tenhobi/maturitni-prace/fotodokumentace/budice-motoru/05.jpg

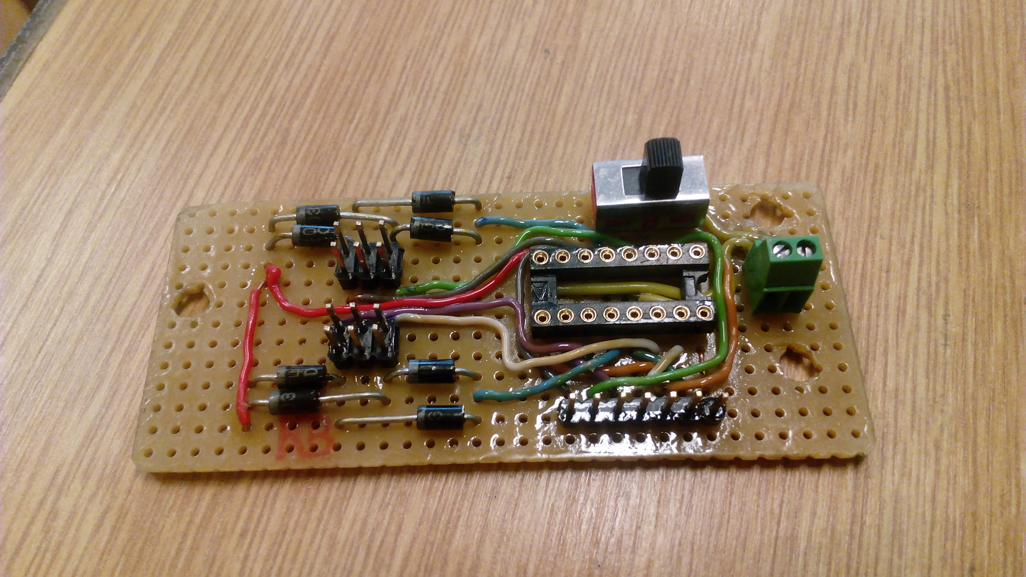
fotodokumentace/budice-motoru/05.jpg
