tenhobi/maturitni-prace/fotodokumentace/ridici-jednotka/12.jpg

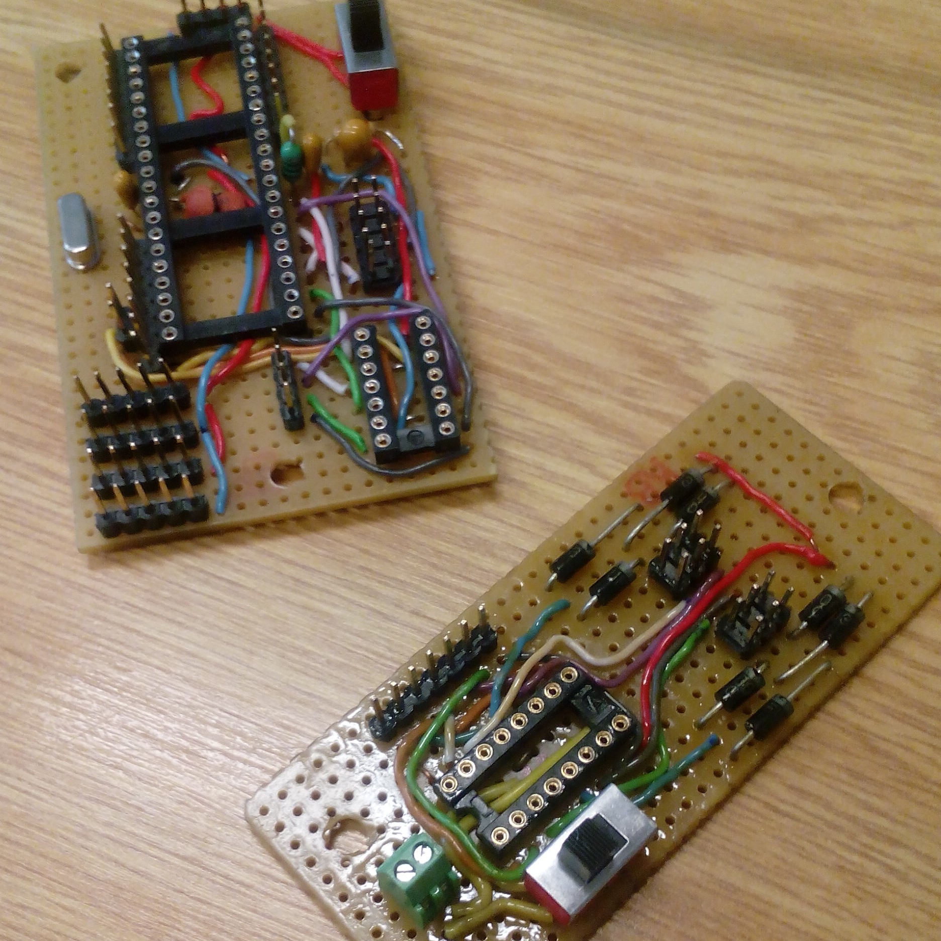
fotodokumentace/ridici-jednotka/12.jpg
