tenhobi/maturitni-prace/README.md

# Maturitní práce

Maturitní práce zabývající se programováním mikrořadiče ATmega32 v jazyku symbolických adres (tj. "assembler") pro dálkové ovládání vozítka postaveného ze stavebnice Merkur s vlastními navrženými deskami plošných spojů pro elektroniku vozítka.
