tenhobi/maturitni-prace/fotodokumentace/budice-motoru/01.jpg

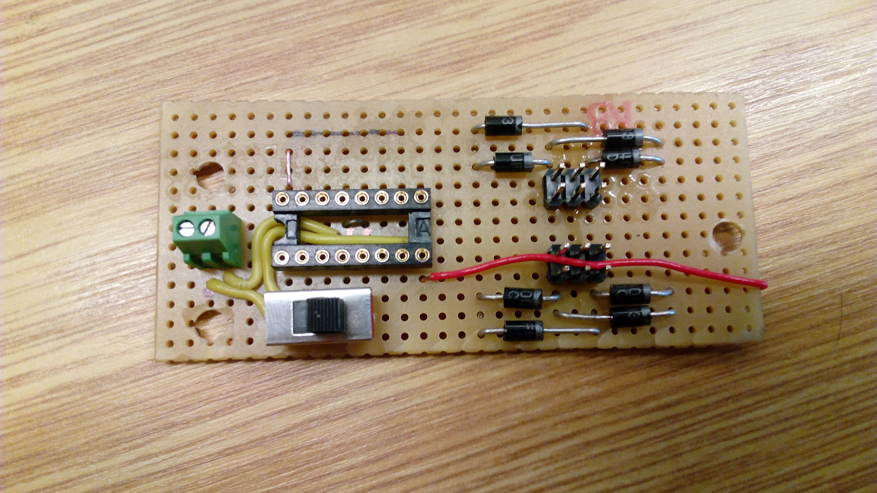
fotodokumentace/budice-motoru/01.jpg
