tenhobi/maturitni-prace/fotodokumentace/budice-motoru/02.jpg

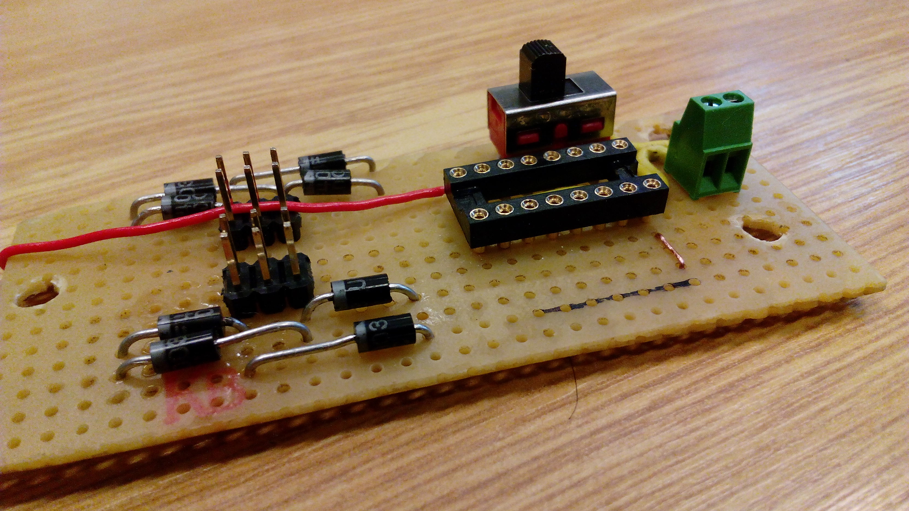
fotodokumentace/budice-motoru/02.jpg
