tenhobi/maturitni-prace/fotodokumentace/budice-motoru/03.jpg

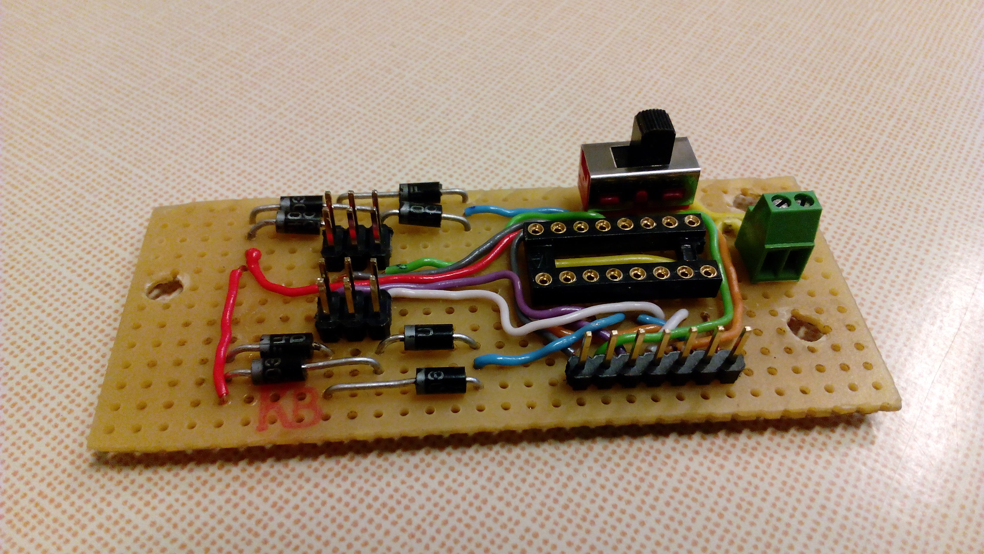
fotodokumentace/budice-motoru/03.jpg
