tenhobi/maturitni-prace/fotodokumentace/budice-motoru/04.jpg

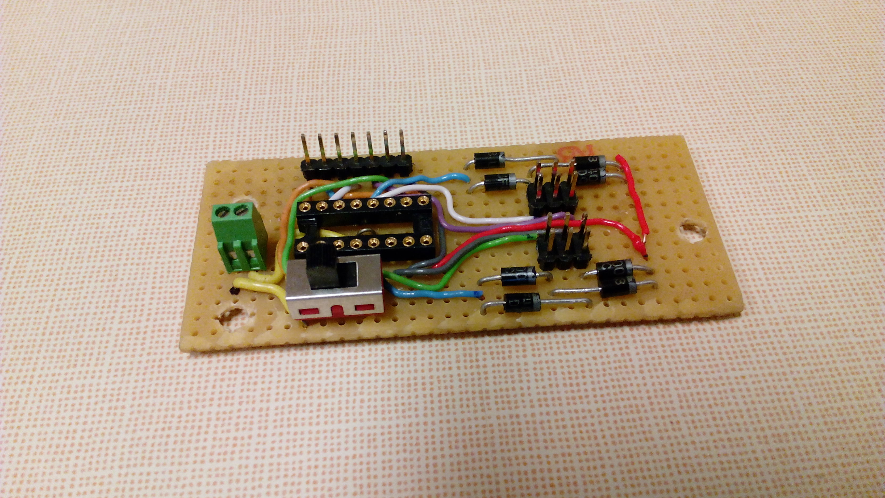
fotodokumentace/budice-motoru/04.jpg
