tenhobi/maturitni-prace/fotodokumentace/model/01.jpg

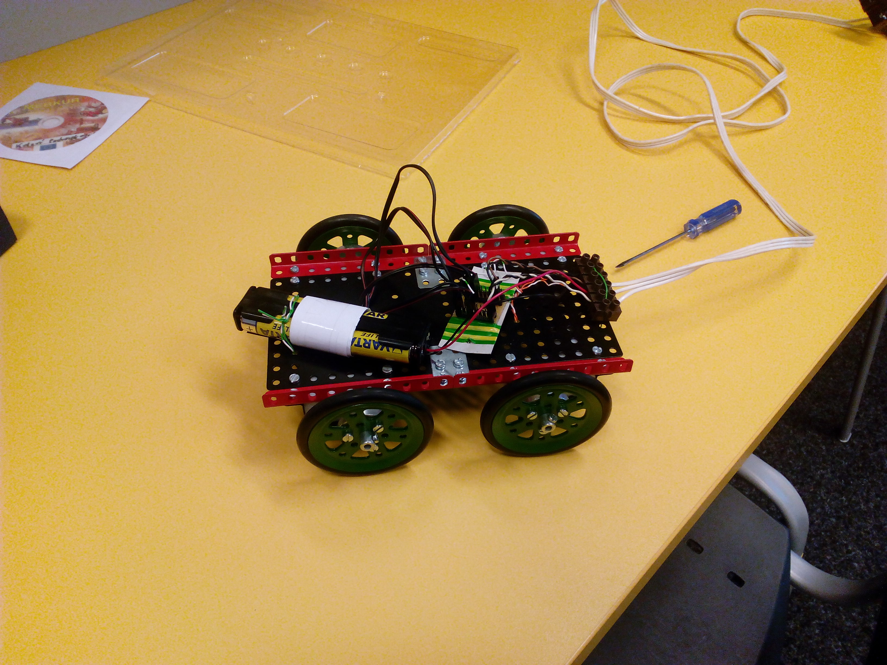
fotodokumentace/model/01.jpg
