tenhobi/maturitni-prace/fotodokumentace/model/02.jpg

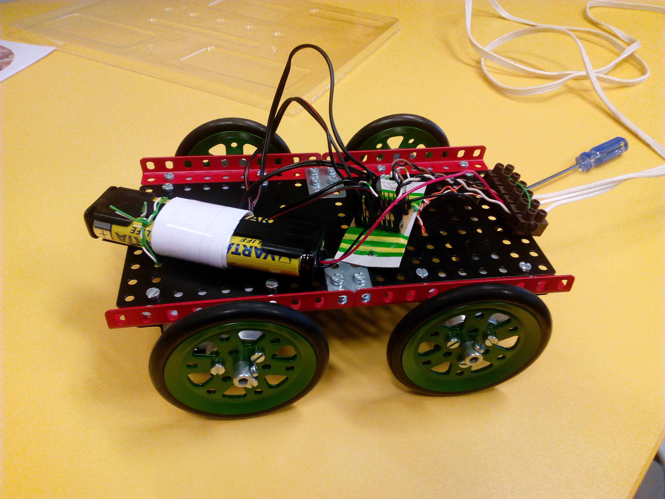
fotodokumentace/model/02.jpg
