tenhobi/maturitni-prace/fotodokumentace/model/03.jpg

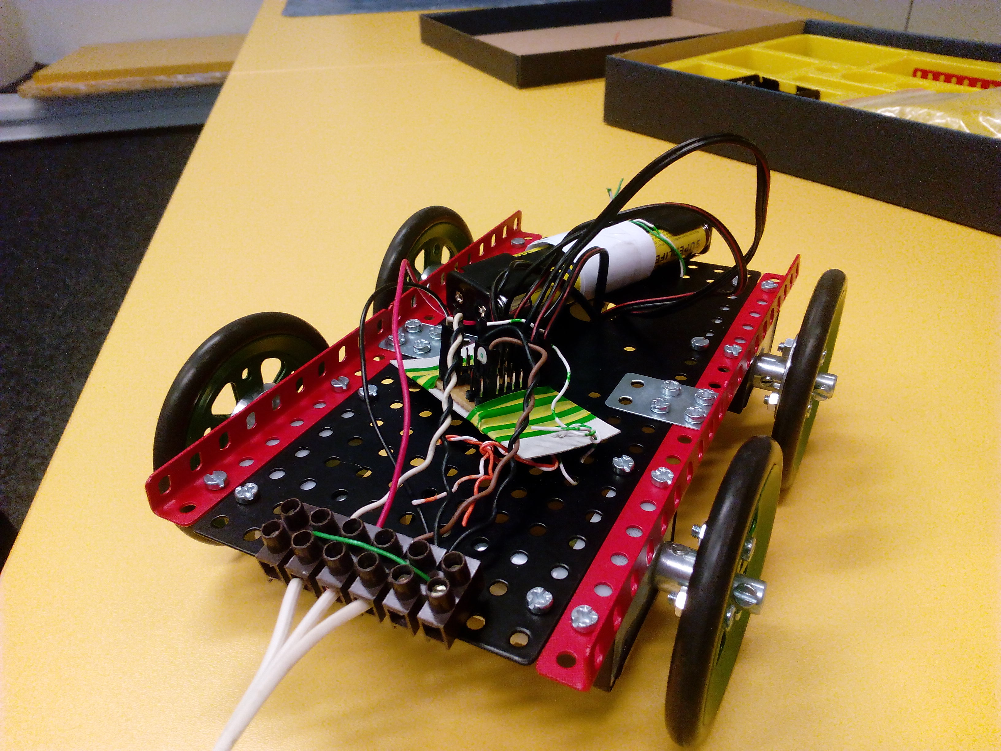
fotodokumentace/model/03.jpg
