tenhobi/maturitni-prace/fotodokumentace/model/04.jpg

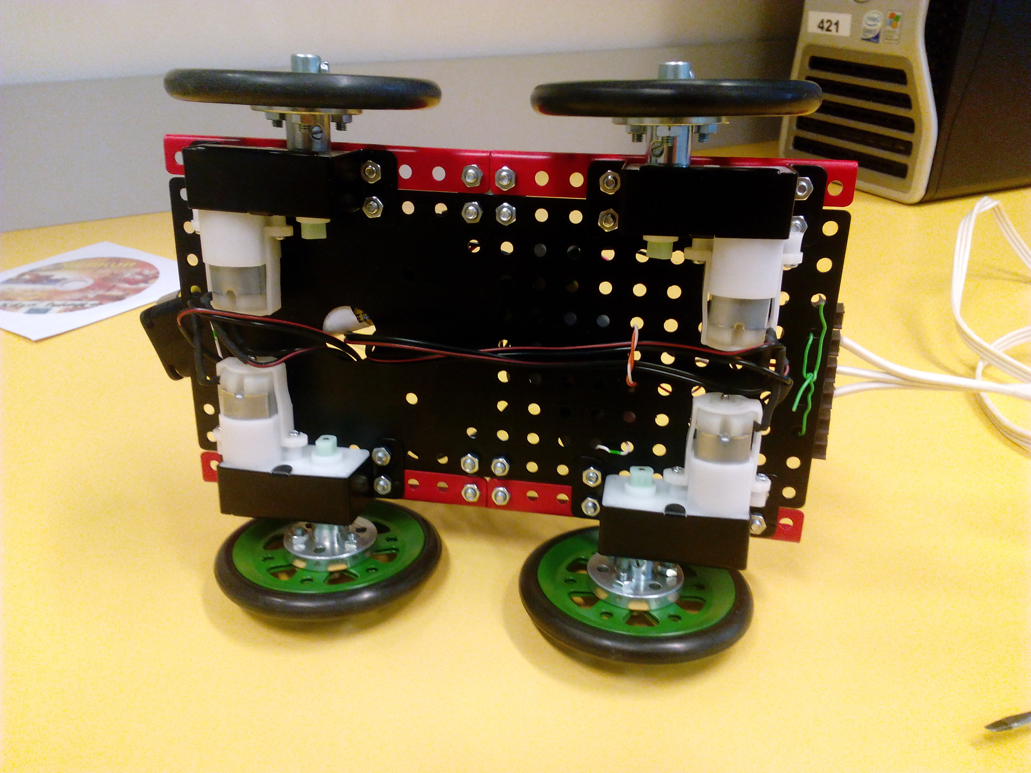
fotodokumentace/model/04.jpg
