tenhobi/maturitni-prace/fotodokumentace/model/05.jpg

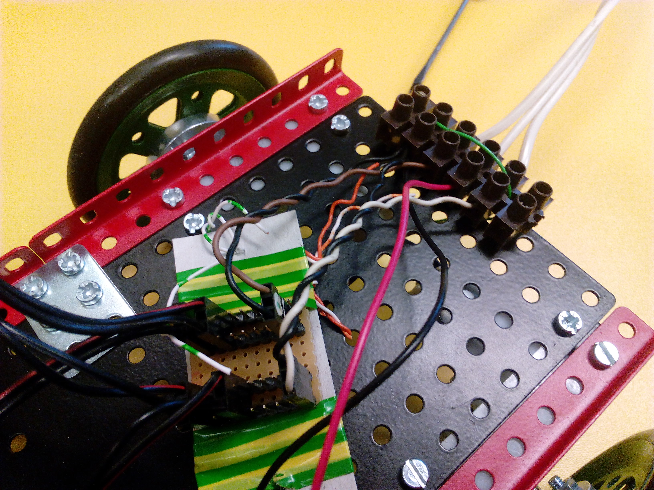
fotodokumentace/model/05.jpg
