tenhobi/maturitni-prace/fotodokumentace/model/06.jpg

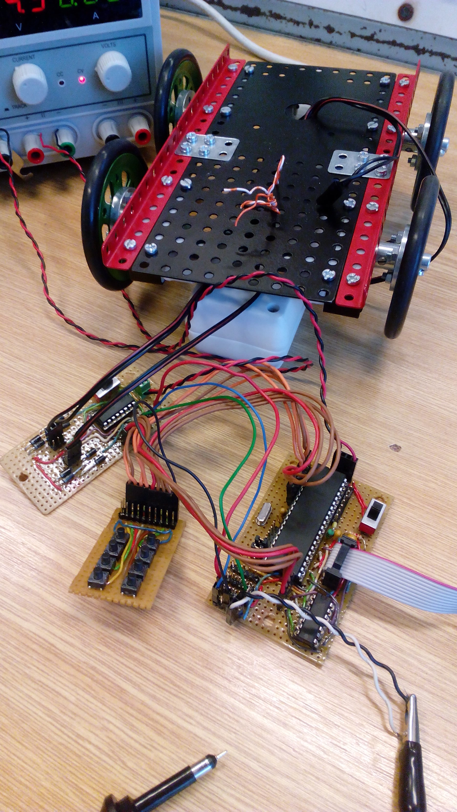
fotodokumentace/model/06.jpg
