tenhobi/maturitni-prace/fotodokumentace/model/07.jpg

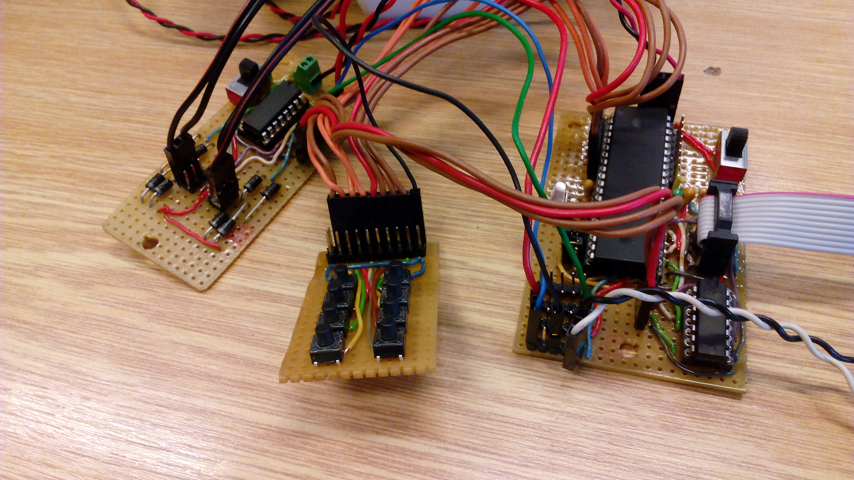
fotodokumentace/model/07.jpg
