tenhobi/maturitni-prace/fotodokumentace/model/08.jpg

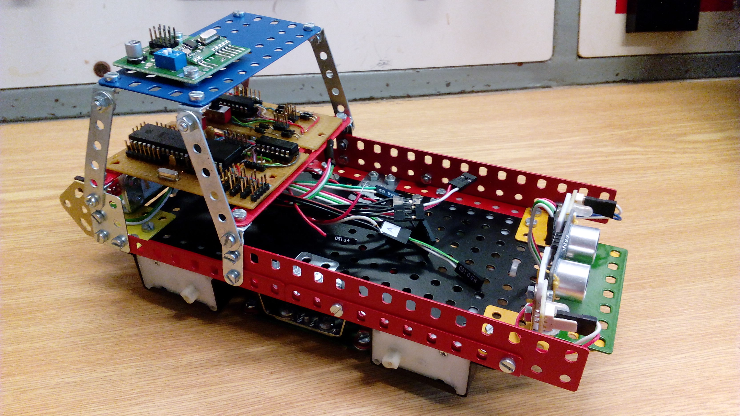
fotodokumentace/model/08.jpg
