tenhobi/maturitni-prace/fotodokumentace/model/09.jpg

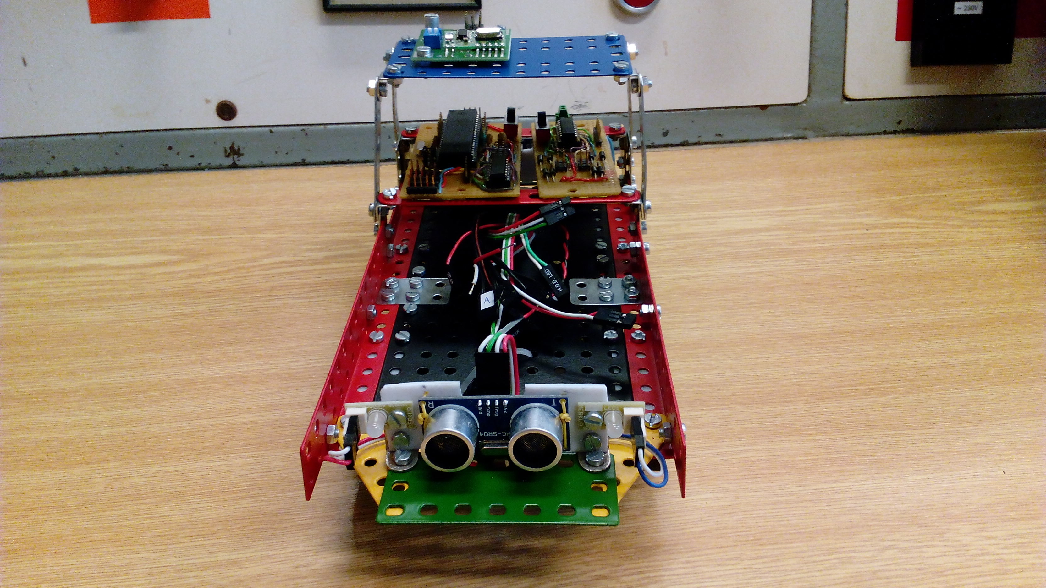
fotodokumentace/model/09.jpg
