tenhobi/maturitni-prace/fotodokumentace/model/10.jpg

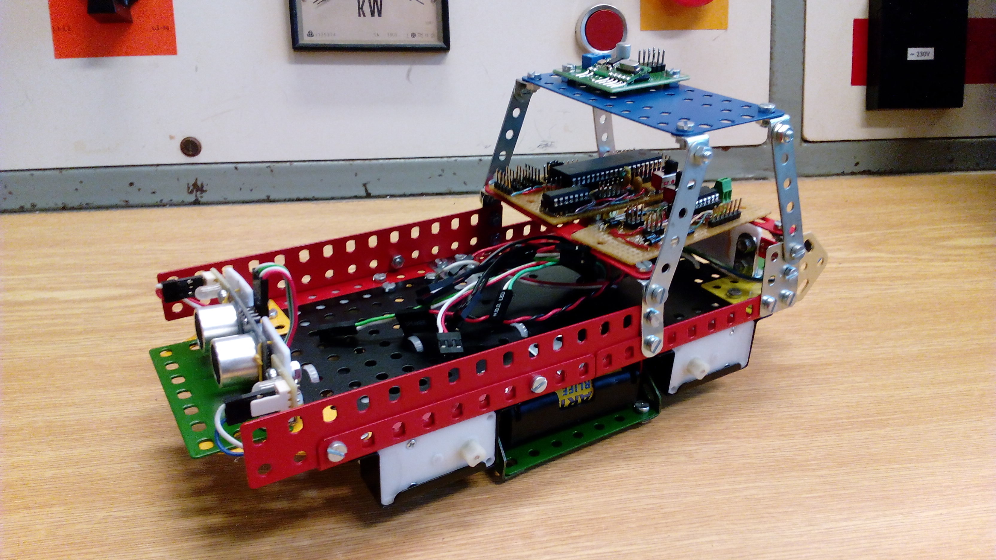
fotodokumentace/model/10.jpg
