tenhobi/maturitni-prace/fotodokumentace/model/11.jpg

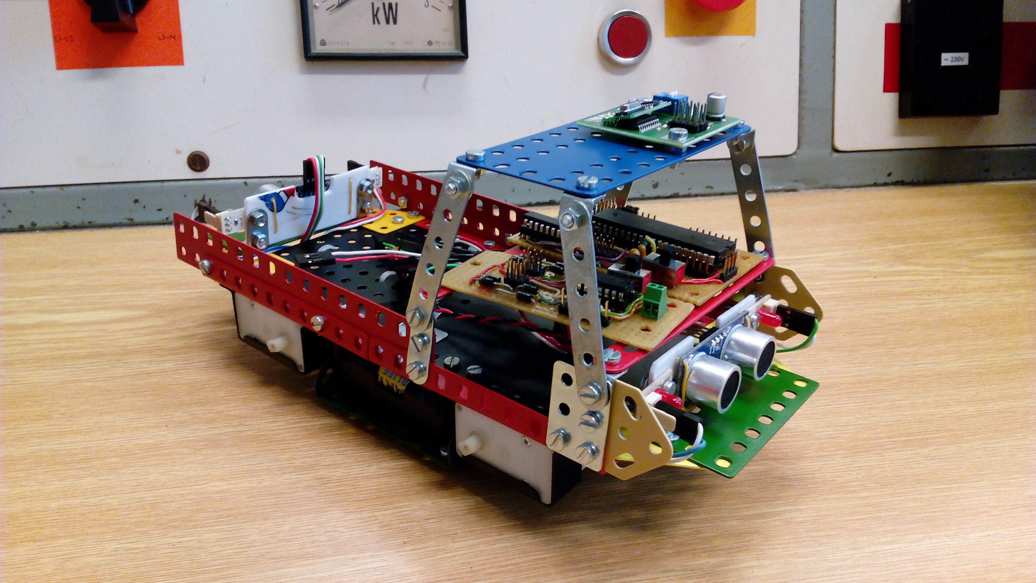
fotodokumentace/model/11.jpg
