tenhobi/maturitni-prace/fotodokumentace/model/12.jpg

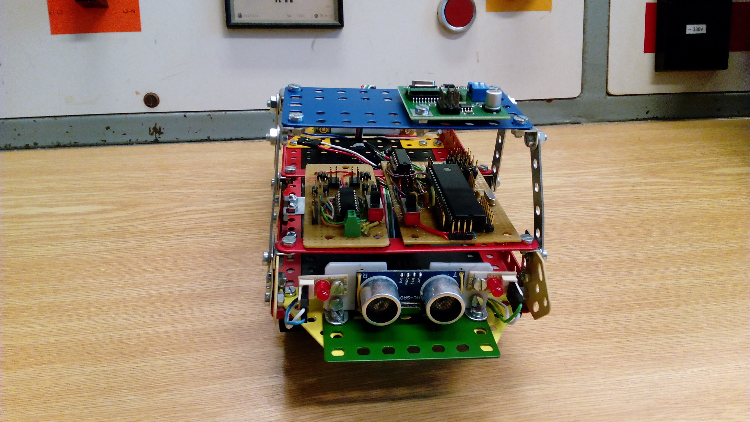
fotodokumentace/model/12.jpg
