tenhobi/maturitni-prace/fotodokumentace/model/13.jpg

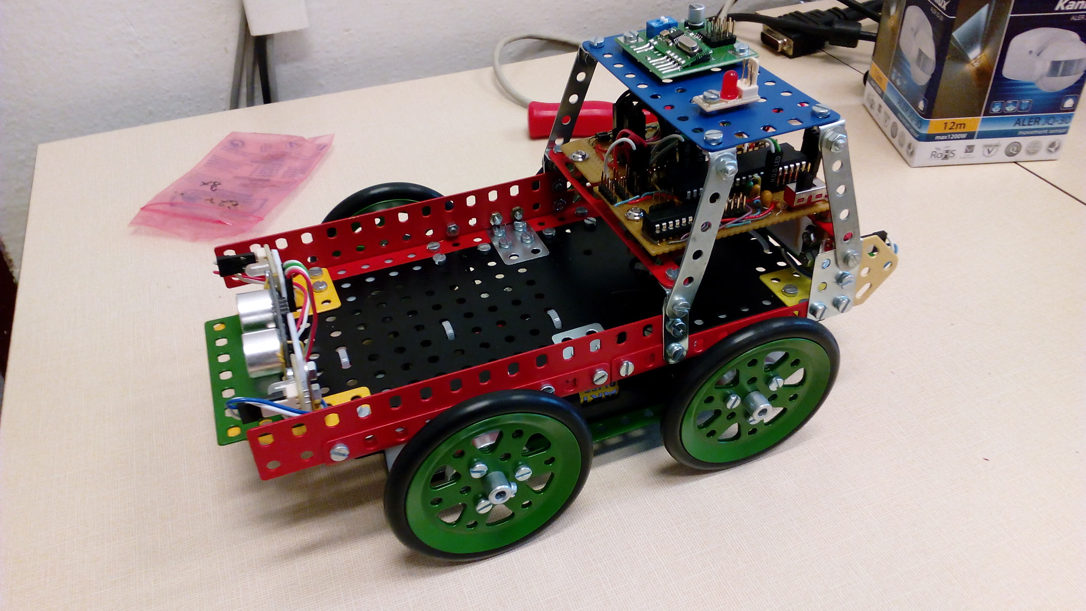
fotodokumentace/model/13.jpg
