tenhobi/maturitni-prace/fotodokumentace/model/14.jpg

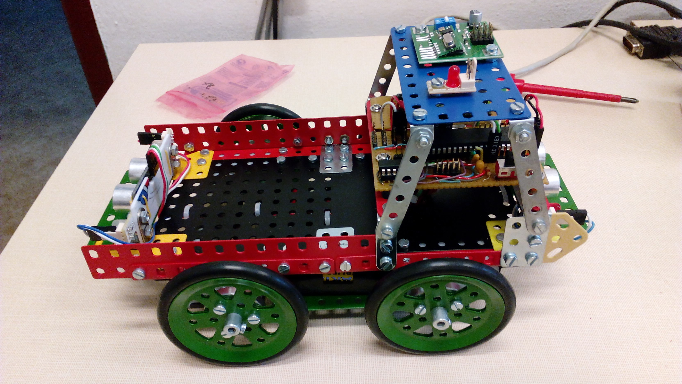
fotodokumentace/model/14.jpg
