tenhobi/maturitni-prace/fotodokumentace/model/15.jpg

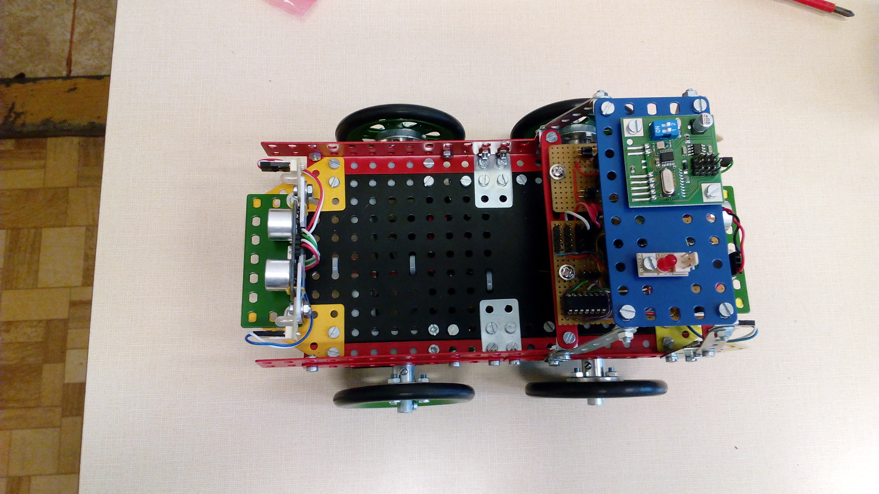
fotodokumentace/model/15.jpg
