tenhobi/maturitni-prace/fotodokumentace/model/16.jpg

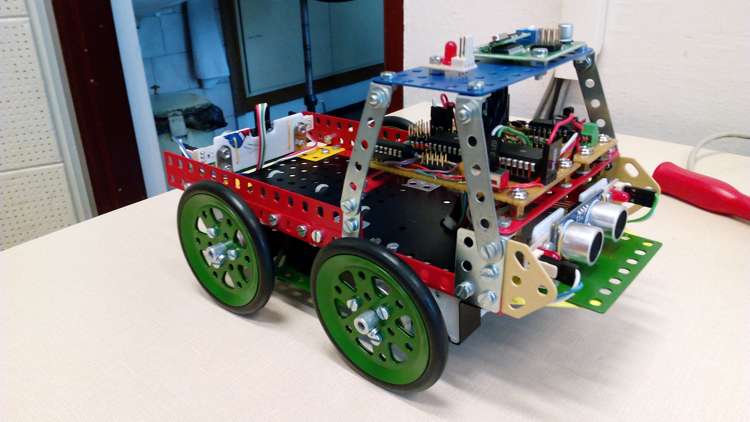
fotodokumentace/model/16.jpg
