tenhobi/maturitni-prace/fotodokumentace/model/17.jpg

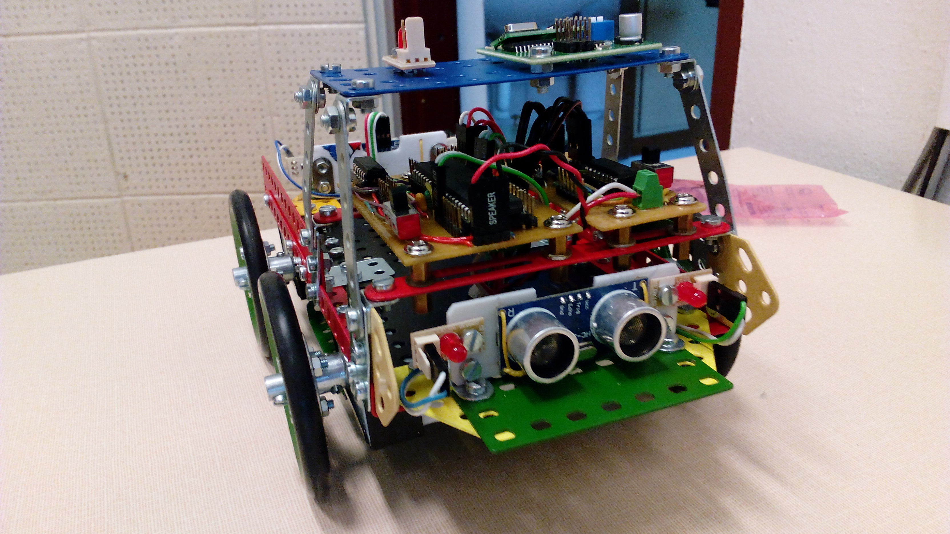
fotodokumentace/model/17.jpg
