tenhobi/maturitni-prace/fotodokumentace/model/IMG_20160309_131850.jpg

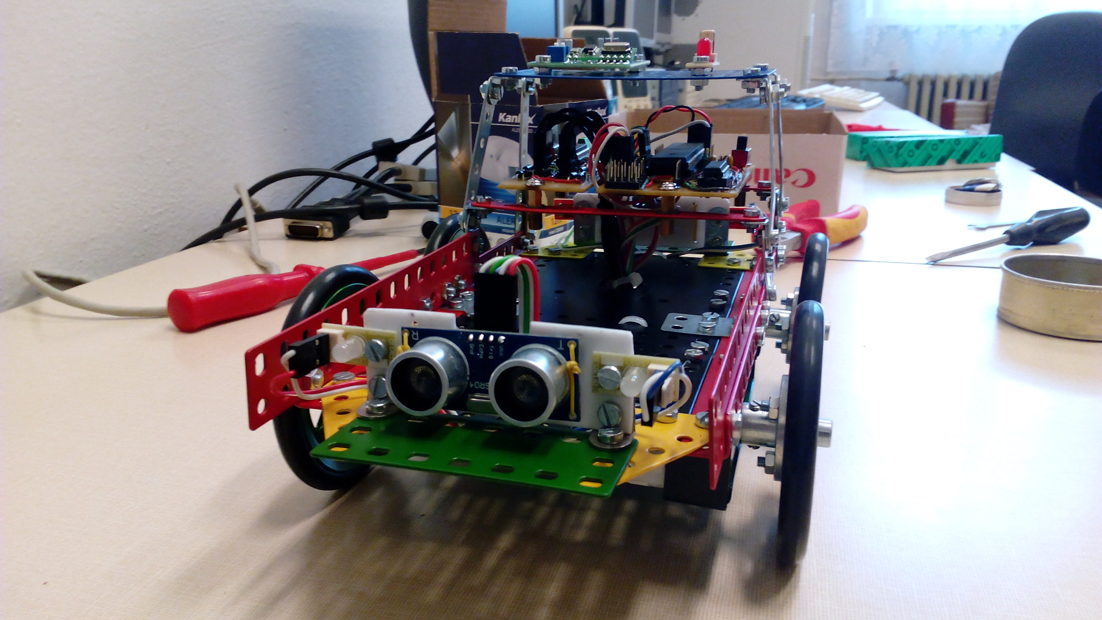
fotodokumentace/model/IMG_20160309_131850.jpg
