tenhobi/maturitni-prace/fotodokumentace/model/IMG_20160309_132029.jpg

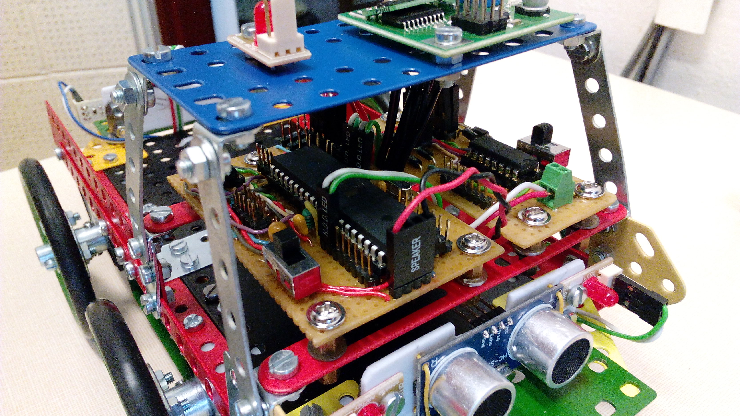
fotodokumentace/model/IMG_20160309_132029.jpg
