tenhobi/maturitni-prace/fotodokumentace/model/IMG_20160310_105314.jpg

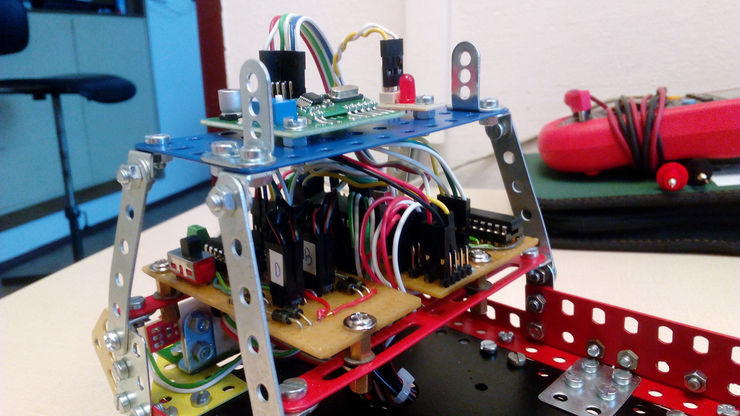
fotodokumentace/model/IMG_20160310_105314.jpg
