tenhobi/maturitni-prace/fotodokumentace/model/IMG_20160310_105325.jpg

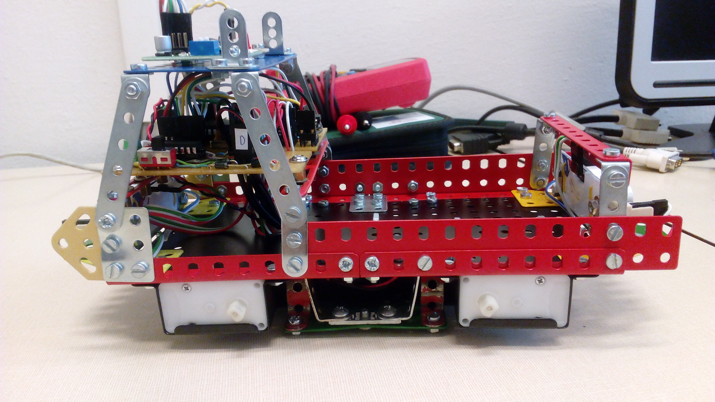
fotodokumentace/model/IMG_20160310_105325.jpg
