tenhobi/maturitni-prace/fotodokumentace/ridici-jednotka/01.jpg

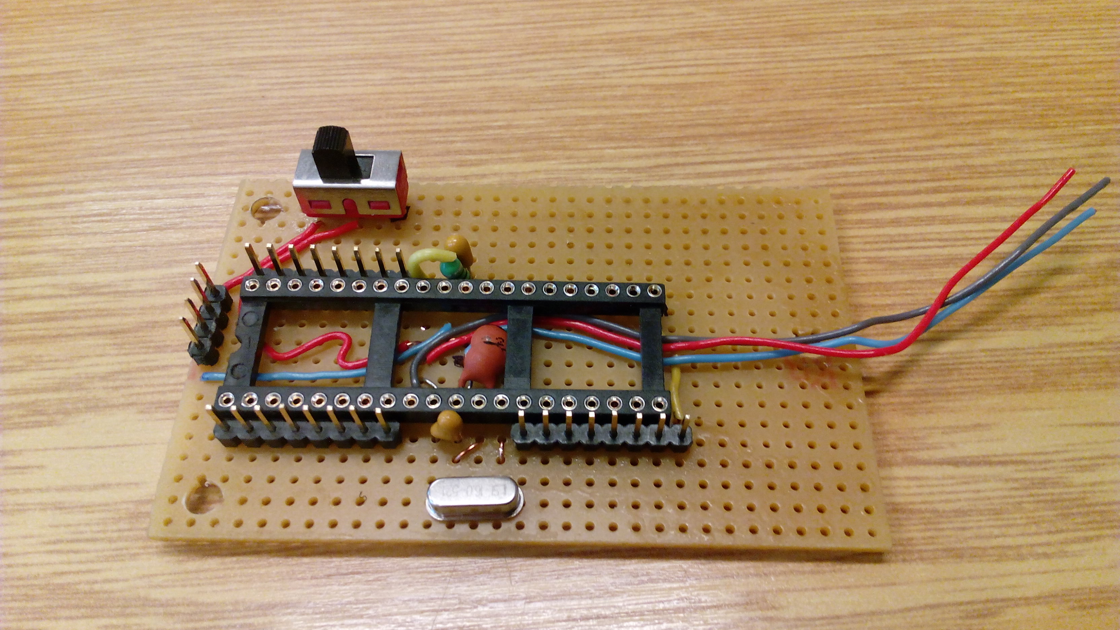
fotodokumentace/ridici-jednotka/01.jpg
