tenhobi/maturitni-prace/fotodokumentace/ridici-jednotka/02.jpg

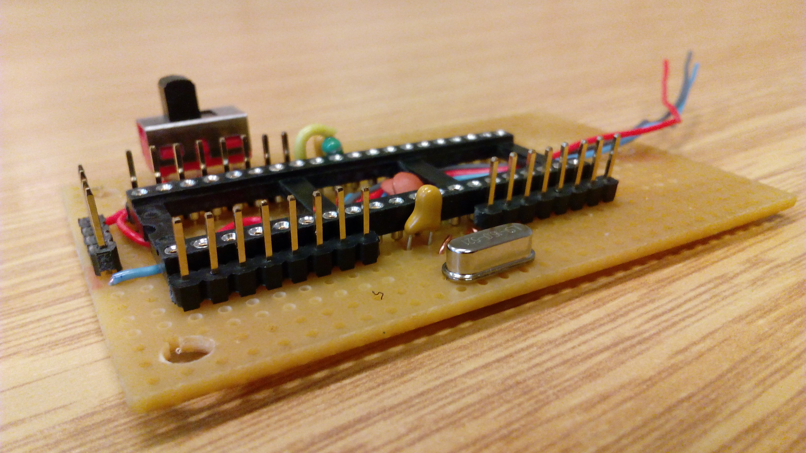
fotodokumentace/ridici-jednotka/02.jpg
