tenhobi/maturitni-prace/fotodokumentace/ridici-jednotka/03.jpg

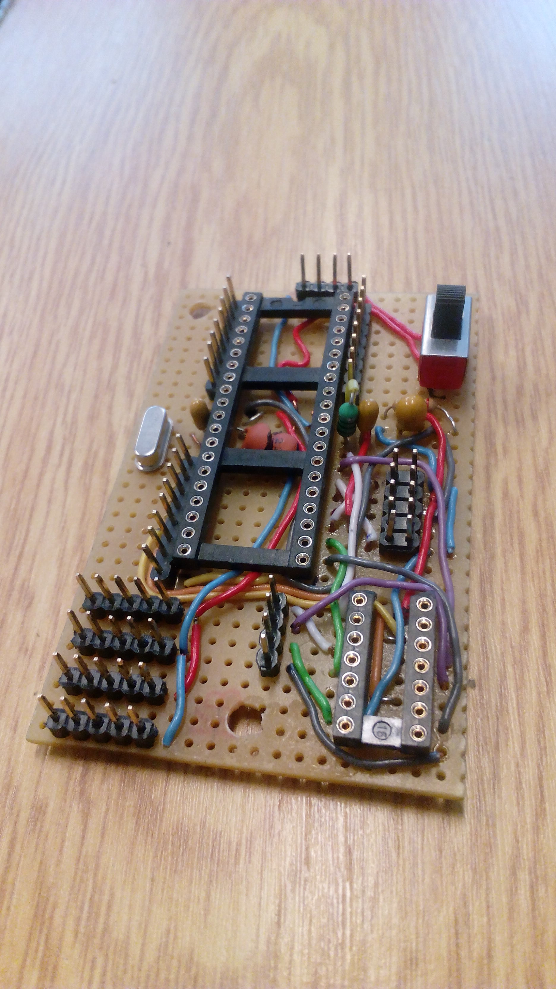
fotodokumentace/ridici-jednotka/03.jpg
