tenhobi/maturitni-prace/fotodokumentace/ridici-jednotka/04.jpg

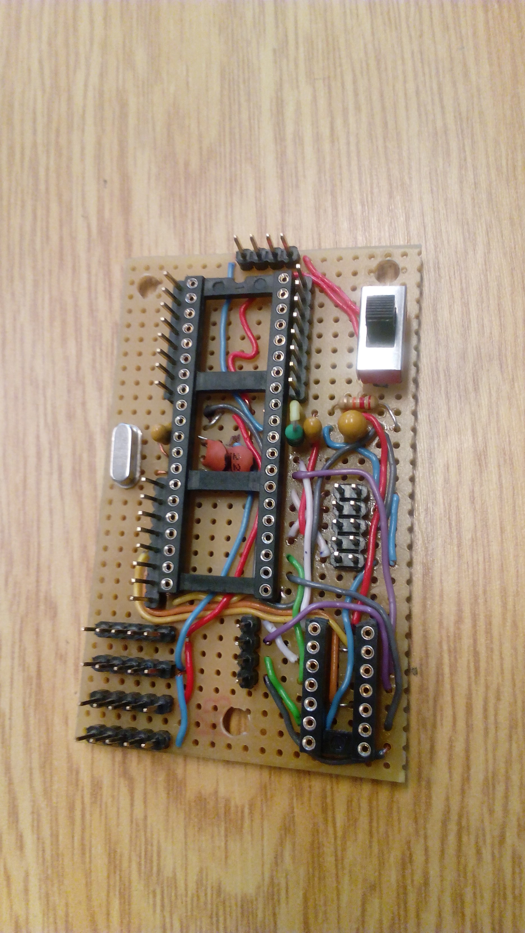
fotodokumentace/ridici-jednotka/04.jpg
