tenhobi/maturitni-prace/fotodokumentace/ridici-jednotka/05.jpg

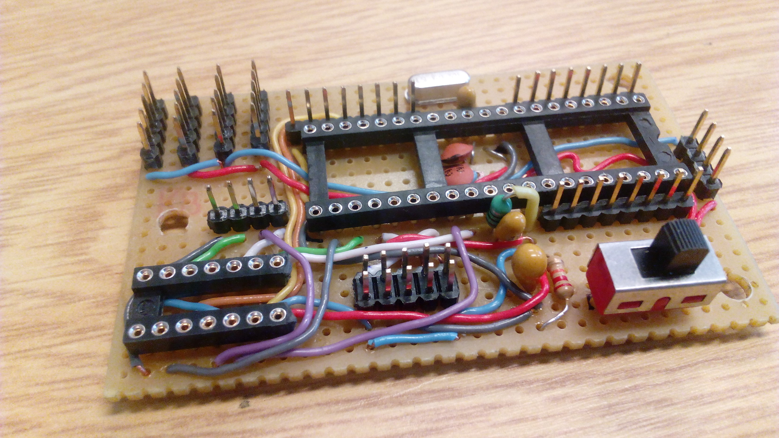
fotodokumentace/ridici-jednotka/05.jpg
