tenhobi/maturitni-prace/fotodokumentace/ridici-jednotka/06.jpg

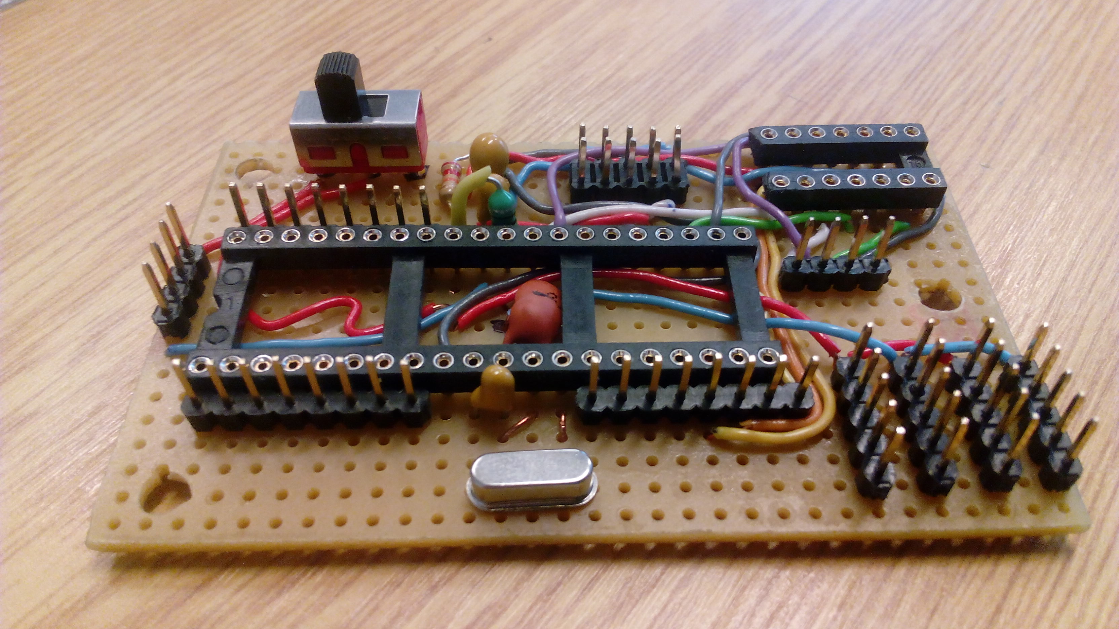
fotodokumentace/ridici-jednotka/06.jpg
