tenhobi/maturitni-prace/fotodokumentace/ridici-jednotka/07.jpg

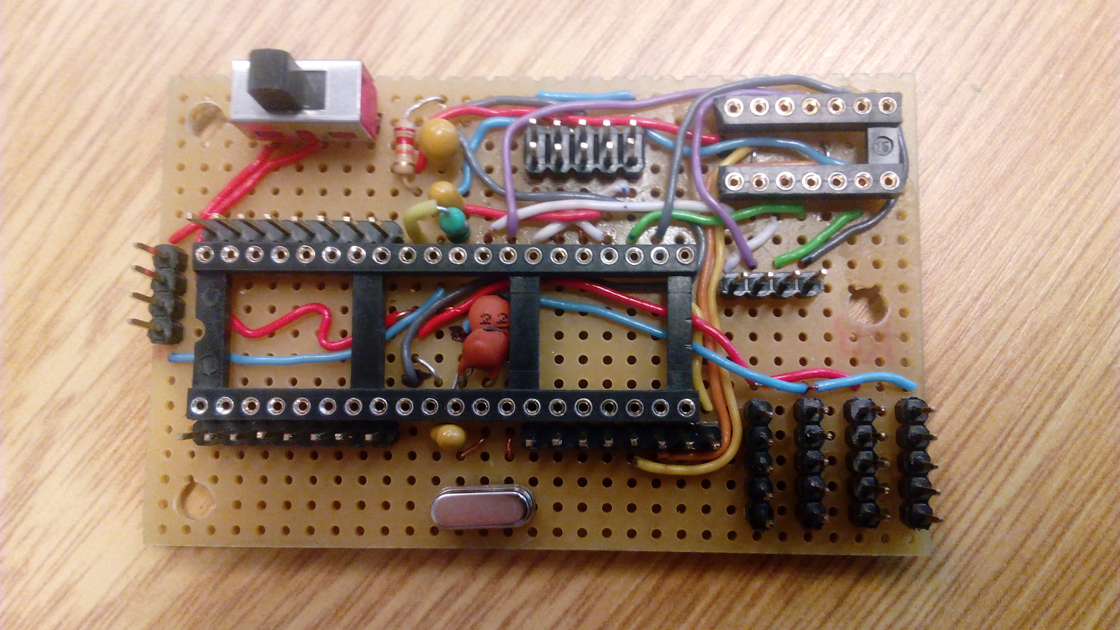
fotodokumentace/ridici-jednotka/07.jpg
