tenhobi/maturitni-prace/fotodokumentace/ridici-jednotka/08.jpg

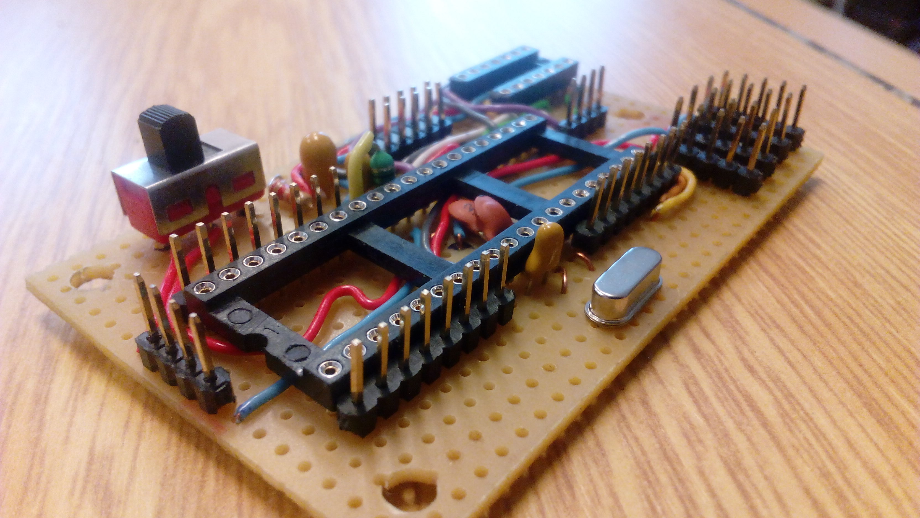
fotodokumentace/ridici-jednotka/08.jpg
