tenhobi/maturitni-prace/fotodokumentace/ridici-jednotka/09.jpg

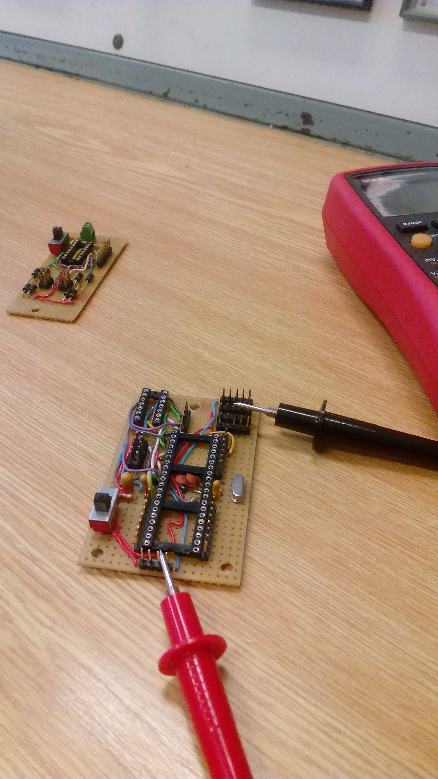
fotodokumentace/ridici-jednotka/09.jpg
