tenhobi/maturitni-prace/fotodokumentace/ridici-jednotka/10.jpg

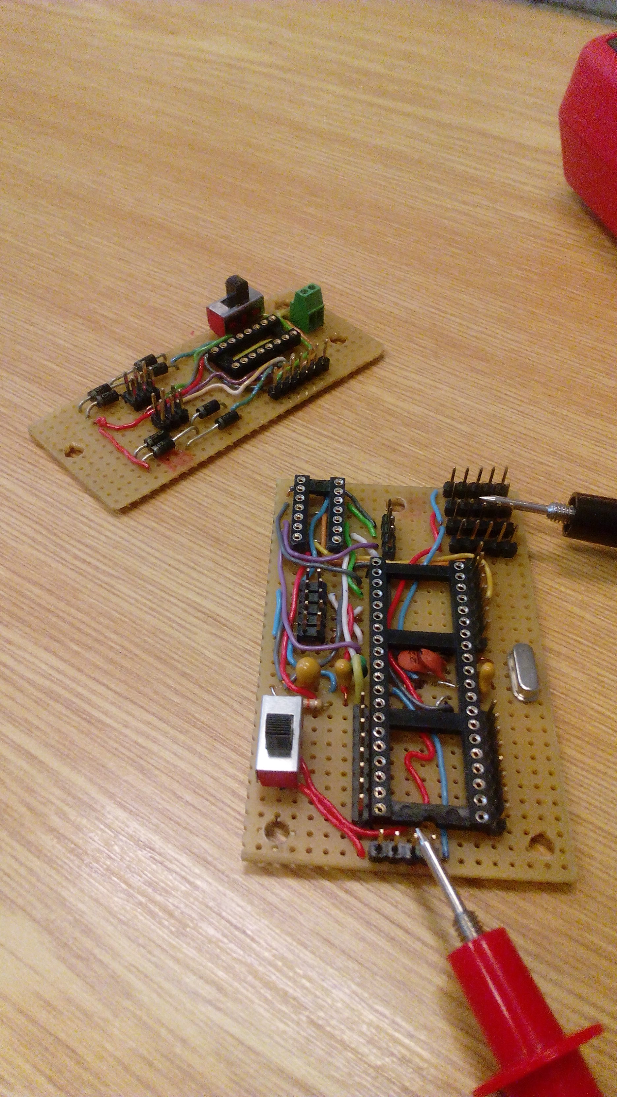
fotodokumentace/ridici-jednotka/10.jpg
