tenhobi/maturitni-prace/fotodokumentace/ridici-jednotka/11.jpg

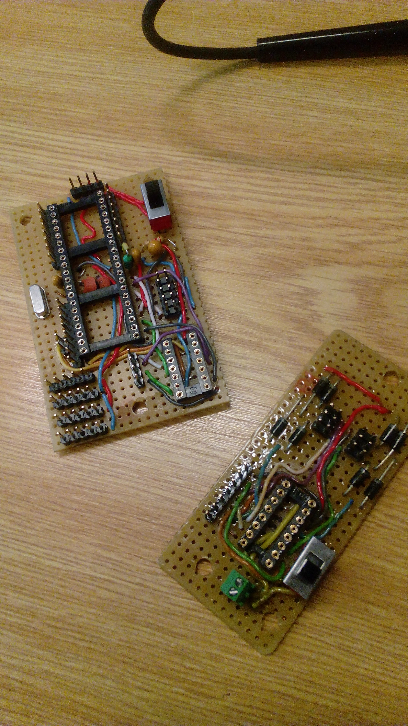
fotodokumentace/ridici-jednotka/11.jpg
