tenhobi/maturitni-prace/fotodokumentace/schema/blokove-schema.png

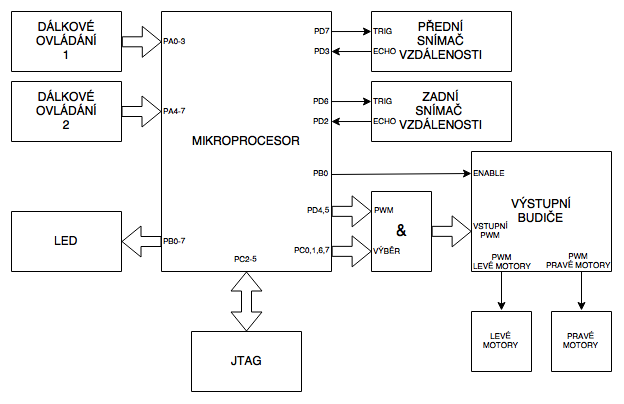
fotodokumentace/schema/blokove-schema.png
