tenhobi/maturitni-prace/fotodokumentace/ultrazvukovy-snimac/01.jpg

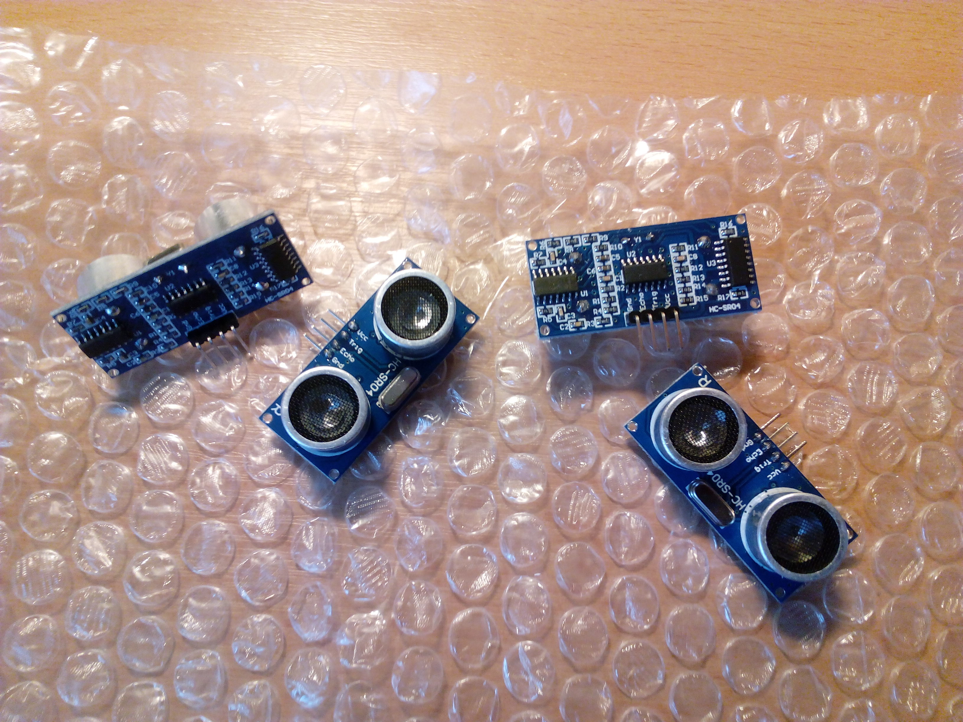
fotodokumentace/ultrazvukovy-snimac/01.jpg
