tenhobi/maturitni-prace/fotodokumentace/ultrazvukovy-snimac/02.jpg

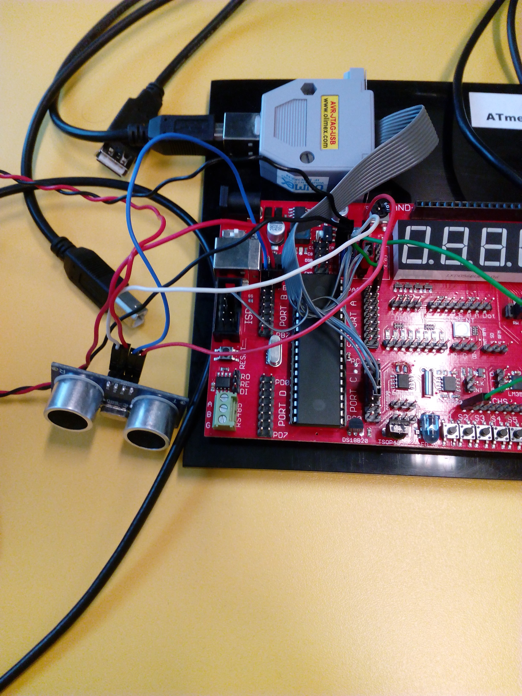
fotodokumentace/ultrazvukovy-snimac/02.jpg
