tenhobi/maturitni-prace/fotodokumentace/ultrazvukovy-snimac/03.jpg

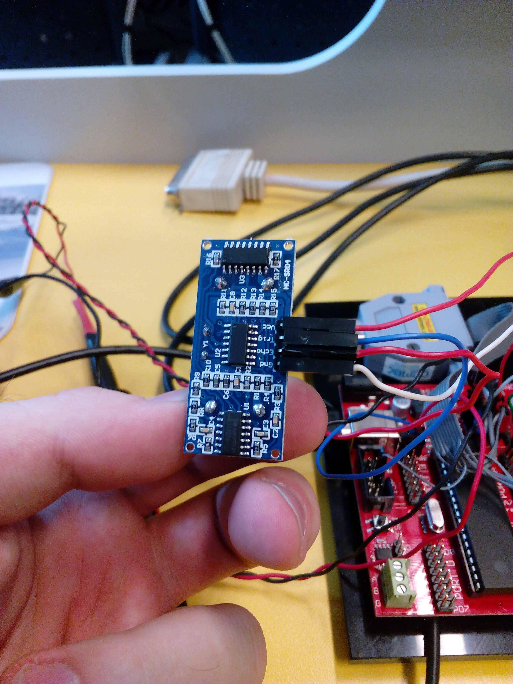
fotodokumentace/ultrazvukovy-snimac/03.jpg
