tenhobi/maturitni-prace/fotodokumentace/ultrazvukovy-snimac/04.jpg

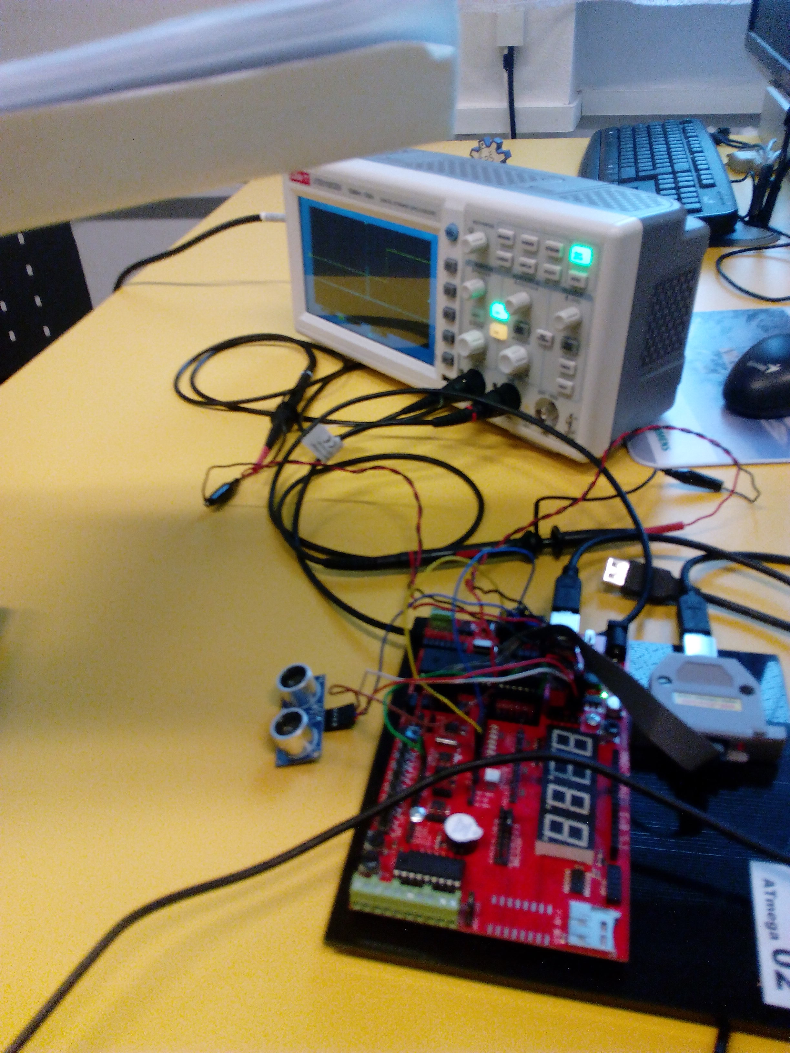
fotodokumentace/ultrazvukovy-snimac/04.jpg
