tenhobi/maturitni-prace/fotodokumentace/ultrazvukovy-snimac/05.jpg

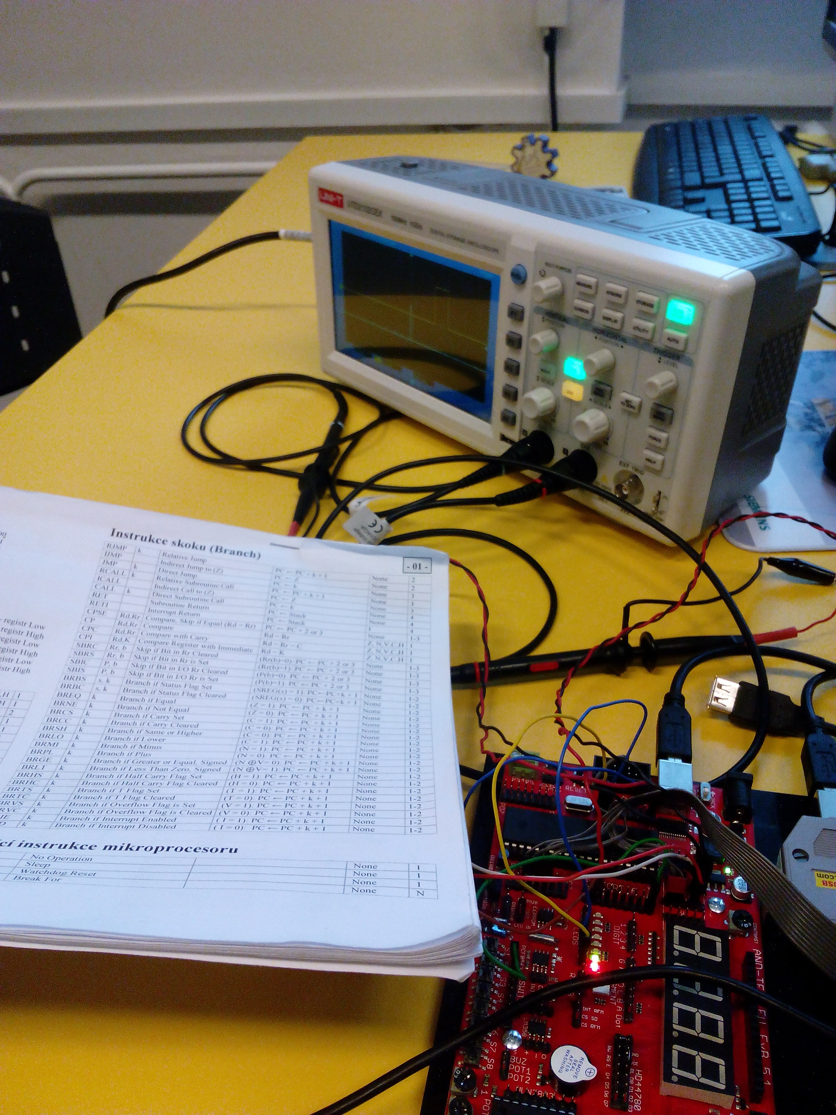
fotodokumentace/ultrazvukovy-snimac/05.jpg
