tenhobi/maturitni-prace/(list of files, cad)

Other CAD files:
program/final/RV03.obj
program/PWM01/PWM01.obj
program/RC01/RC01.obj
program/UZ02/UZ02.obj
